vishnu350/rs-mainspring-winder/misc/staplejig.stl

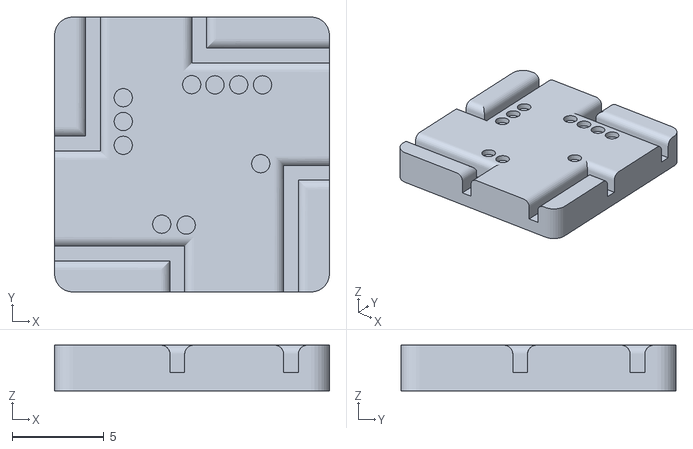
[picture p1: CAD file, 2022-07-30]
misc/staplejig.stl
15.0 x 15.0 x 2.50
