vishnu350/rs-mainspring-winder/rs-winder.FCStd

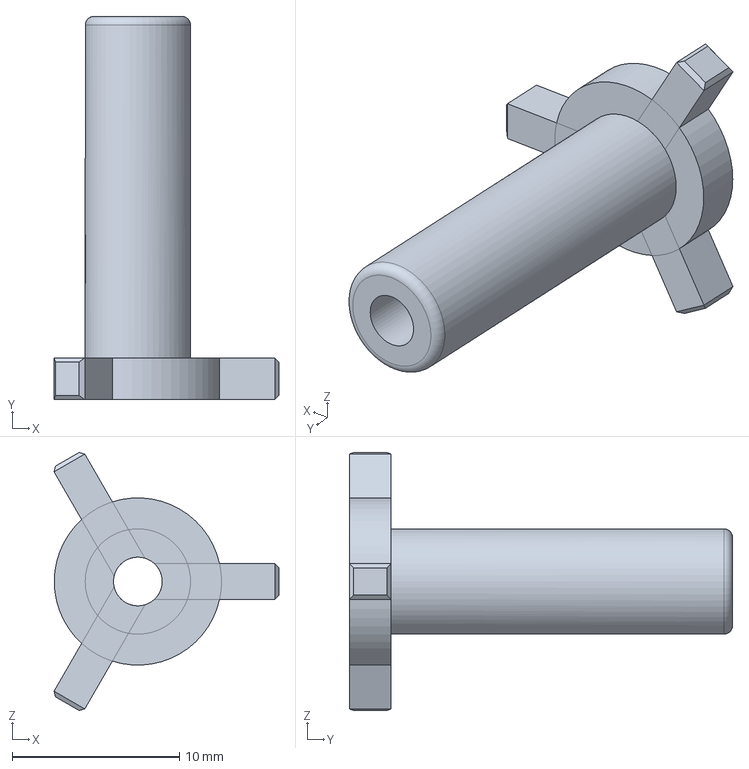
[picture p2: CAD file, 2026-08-27]
rs-winder.FCStd
13.5 x 22.9 x 15.4 mm
