vishnu350/rs-mainspring-winder/misc/sharpener_v2.FCStd

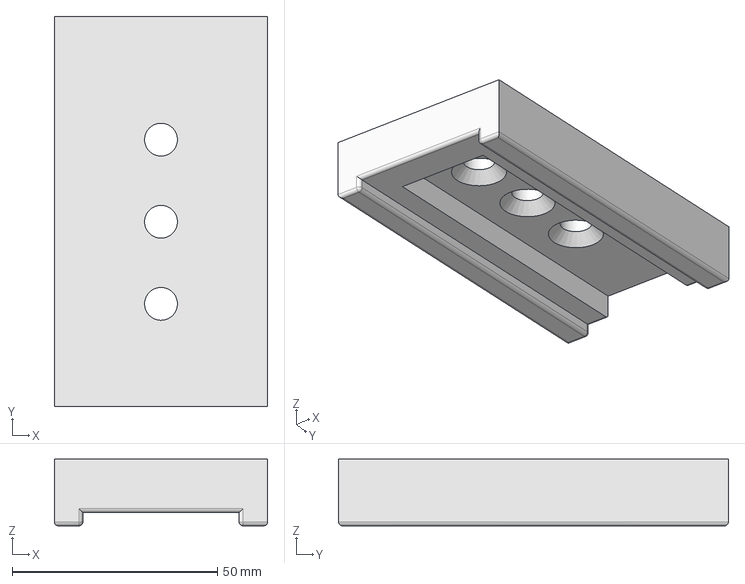
[picture p3: CAD file, 2022-07-15]
misc/sharpener_v2.FCStd
52.0 x 95.0 x 16.2 mm
