vishnu350/rs-mainspring-winder/legacy/rs-winder-v4.FCStd

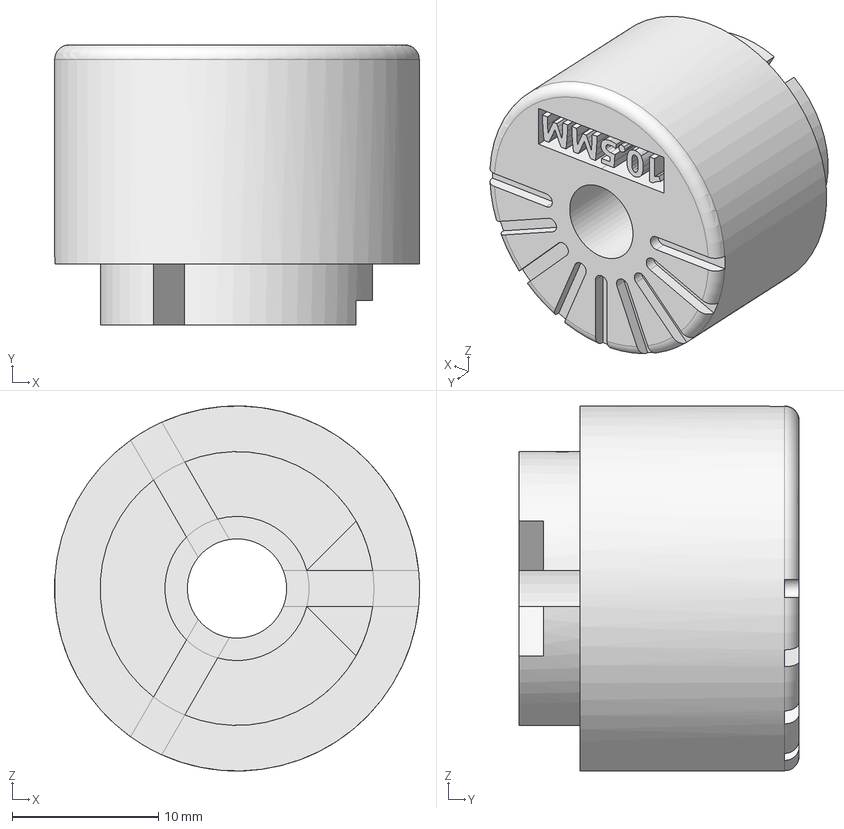
[picture p4: CAD file, 2021-05-20, an earlier design]
legacy/rs-winder-v4.FCStd
25.0 x 19.2 x 25.0 mm
