vishnu350/rs-mainspring-winder/legacy/rs-winder-v2.FCStd

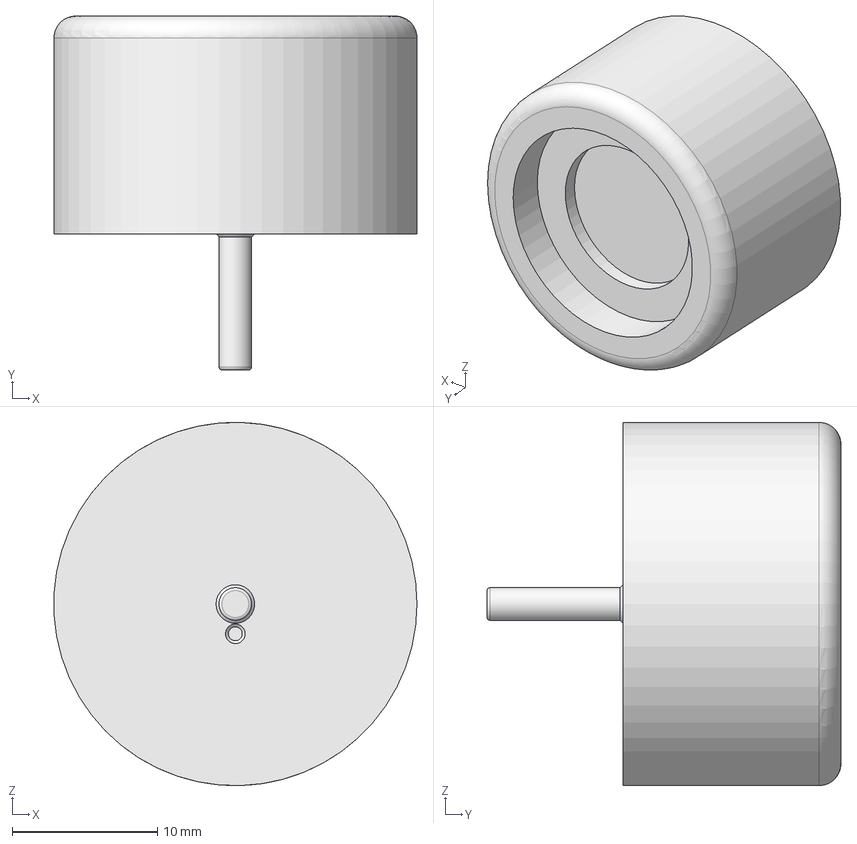
[picture p5: CAD file, 2021-05-15, an earlier design]
legacy/rs-winder-v2.FCStd
25.0 x 24.4 x 25.0 mm
