vishnu350/rs-mainspring-winder/legacy/rs-winder-v1.FCStd

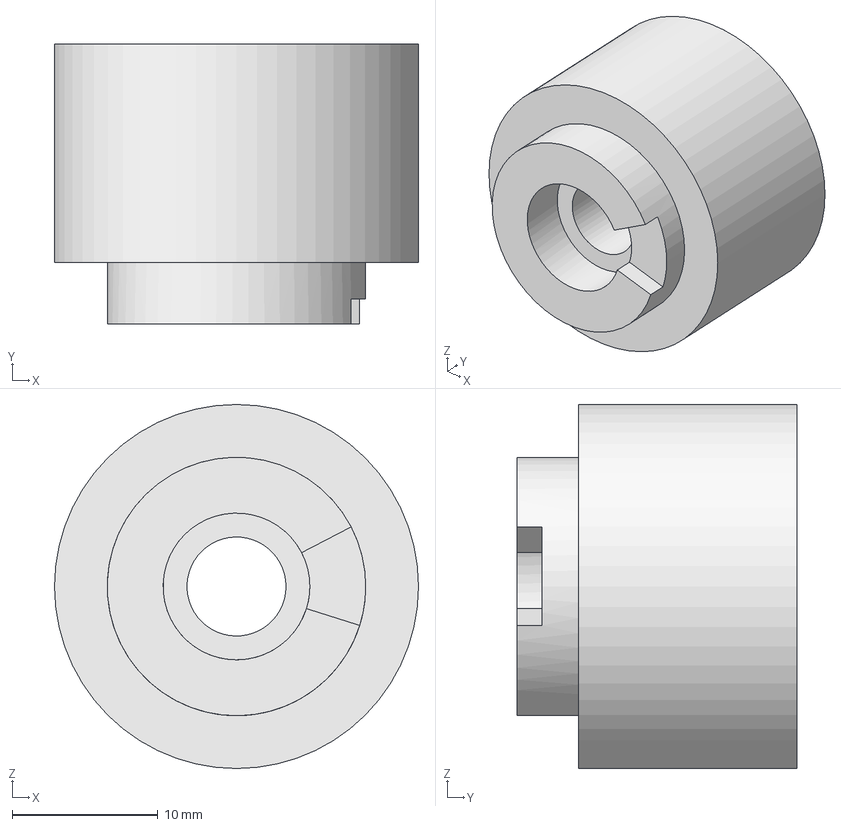
[picture p6: CAD file, 2021-05-15, an earlier design]
legacy/rs-winder-v1.FCStd
25.0 x 19.2 x 25.0 mm
