vishnu350/rs-mainspring-winder/legacy/rs-winder-v3.FCStd

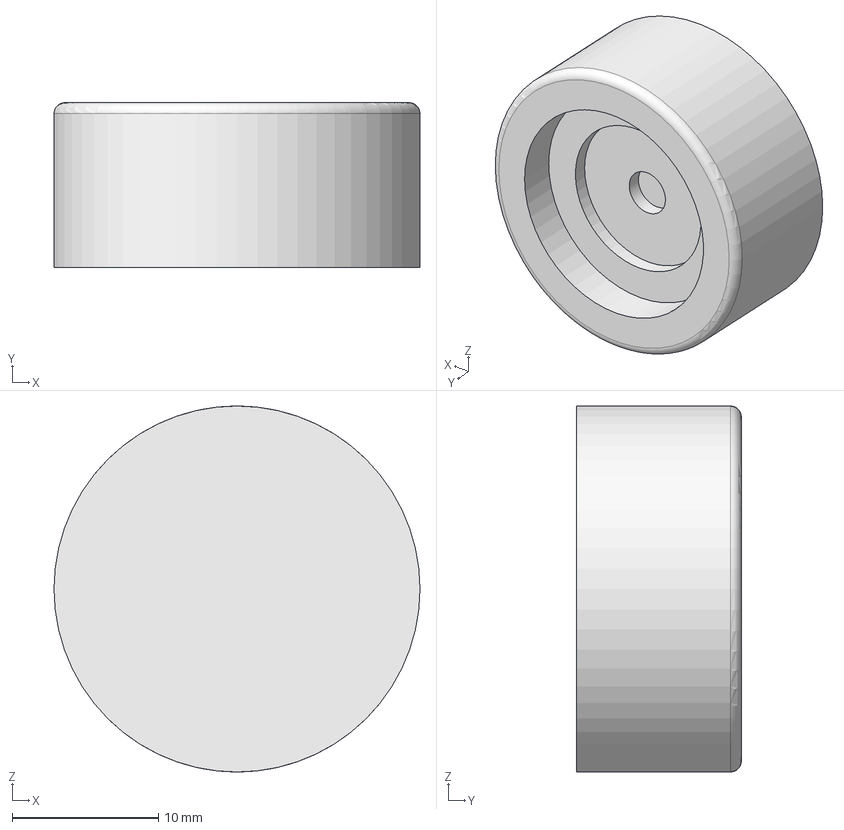
[picture p7: CAD file, 2021-05-05, an earlier design]
legacy/rs-winder-v3.FCStd
25.0 x 11.3 x 25.0 mm
