vishnu350/rs-mainspring-winder/(threads)

Thread 3 (2022-07-26):

Vintage circular coil type mainsprings will not easily fit in some smaller winders

vishnu350, 2022-07-26:
Vintage mainsprings (circular coil instead of S coil) will not easily fit in the winder due to the thick walls. See: https://www.watchrepairtalk.com/topic/19340-3d-printed-rs-mainspring-winder-project-for-hobbyists/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

vishnu350, 2022-07-27:
Experimental small winder attached.
[rs-winder-exp-small-v1.zip](https://github.com/vishnu350/rs-mainspring-winder/files/9201300/rs-winder-exp-small-v1.zip)
.

vishnu350, 2022-07-30:
User feedback is good on the new small winder version:
https://www.watchrepairtalk.com/topic/19340-3d-printed-rs-mainspring-winder-project-for-hobbyists/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

Closed 2023-01-06.

Thread 4 (2022-07-26):

Missing M3 arbour rod sizes for large winder set

vishnu350, 2022-07-26:
For the largest spectrum of winders, an M3 arbour rod size would be required.

vishnu350, 2022-08-01:
Resolved in latest version.

Closed 2022-08-01.

Thread 5 (2022-07-26):

Missing M1.5 arbour rod sizes for small winder set

vishnu350, 2022-07-26:
For the smallest spectrum of winders, an M1.5 arbour rod would be ideal.

vishnu350, 2022-08-01:
Resolved in latest release.

Closed 2022-08-01.

Thread 6 (2022-07-26):

Staple pins do not work well in the 7mm mainspring range

vishnu350, 2022-07-26:
Staple pins do not work well in the 7mm mainspring range, as they have hole sizes of 0.25mm which is too small. See: https://www.watchrepairtalk.com/topic/19340-3d-printed-rs-mainspring-winder-project-for-hobbyists/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

vishnu350, 2022-07-27:
Currently the only workaround is to file down the staple pin, or just buy a [0.2mm spring steel](https://www.aliexpress.com/item/4000995284553.html) and fashion into the arbour hook with the staplejig.

Thread 7 (2022-07-26):

Retire the winder base with 3D printed arbor rod

vishnu350, 2022-07-26:
This part needs to be retired to avoid issues with users accidentally printing this version and suffering.

vishnu350, 2022-08-05:
Latest release no longer has this part.

Closed 2022-08-05.

Thread 8 (2022-07-26):

Retire the barrel bowl and insert the arbour hole in setter bowl instead

vishnu350, 2022-07-26:
This part is no longer needed.

Only advantage of barrel bowl is the arbour hole that helps with snapping the barrel lid back on. This feature needs to be inserted into the setter bowl and then this part can be retired.

AndyShap2020, 2022-07-28:
I think I have already addressed this issue. In the "Placing Base" I have created, I designed it with a hole accommodate the arbor.

vishnu350, 2022-08-05:
Latest release no longer has this part.

Closed 2022-08-05.

Thread 10 (2022-07-30):

The winder size text never prints out cleanly

vishnu350, 2022-07-30:
This issue may be due to elephants feet issue since the text is printed on the bed.
**Solution**: Maybe switch text to embossed instead of extruded.

vishnu350, 2022-11-19:
Still doesn't print properly in v0.91 with embossed text.

vishnu350, 2022-11-20:
Fixed in v0.95

Closed 2022-11-20.

Thread 11 (2022-07-30):

Fillets too small in some parts, causing elephants foot

vishnu350, 2022-07-30:
Housing barrel and bowl fillets are too small.

vishnu350, 2022-11-18:
Fixed in v0.9.

Closed 2022-11-18.

Thread 12 (2022-07-30):

Barrel walls for 17.5mm-18.5mm too thin

vishnu350, 2022-07-30:
Barrel walls for the 17.5mm-18.5mm ranges are too thin, not sure if this is suitable for actual use especially since this is on the large spectrum.

vishnu350, 2024-04-11:
Since no one has complained about the latest version, closing this for now.

Closed 2024-04-11.

Thread 9 (2022-07-30):

Spring diameter shrink % parameter may not be needed?

vishnu350, 2022-07-30:
Currently, winders have a preset 5% reduced size to be able to properly handle matching barrel sizes. This may be confusing to some users who choose slightly smaller winders by default.
Eg. if the winder was labelled 10mm but it has a preset 5% reduced size to be able to properly handle a 10mm mainspring (thus actually making it 9.5mm or so).

vishnu350, 2022-08-27:
Experimental version with shrink param set to 0: [rs-winder-v0.87.zip](https://github.com/vishnu350/rs-mainspring-winder/files/9437245/rs-winder-v0.87.zip)

vishnu350, 2022-09-02:
Latest release resolves this issue.

Closed 2022-09-02.

Thread 13 (2022-11-07):

Housing depth too deep?

jhaals, 2022-11-07:
Hi and first of all fantastic to see an open source mainspring winder! Really love the idea!

I printed the latest 0.91 release but I'm experiencing some issues while winding the mainspring. Primarily that it tends to not align height wise if that makes sense. Basically the main spring does not lie flat and some part of the spring taking up more space vertically. Inspecting the housing of the housing it is basically twice the height of the mainspring. Are there a good reason for doing it that way or does it make sense for the housing to be slimmed down?

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

The spring takes up all spaces marked in red where 50% of the height would be enough.

Thanks again for taking on this project 👏

vishnu350, 2022-11-08:
Thanks for the support. Actually, I just press down on the plunger to bring it down flush just before I start winding. It stays that way until the end, no issues. Have you tried that?

The parameter that you are referring to is the max spring height (spr_h). You may change it and regenerate it if you wish. The large default value that we set is because there are mainsprings that can be up to 3mm in height, filtered by popularity on cousins UK. There is no standards for these things unfortunately, so we have to include support for the upper limit.

jhaals, 2022-11-08:
I do try pushing with the plunger at the beginning, it might be that the extra hight allows it to climb up if not perfectly fed in perfectly straight. I will give it a few extra tries or adjust the spring hight as you suggest, thanks for sharing the parameter as that might be a quick option to prevent the risk entirely 👍

vishnu350, 2022-11-12:
You may check Andy's video at min 0:48: [https://youtu.be/EZvd_MKBOUQ?t=48](https://youtu.be/EZvd_MKBOUQ?t=48). In the video he instructs users to apply continuous pressure to keep the spring flat, this should work in all cases as it would be impossible for it to climb up.

jhaals, 2022-11-13:
Hi!

I did try with another mainspring today but unfortunately it yielded the same result, the sprint curled up. I did apply pressure during winding but the spring curled on the side of the plunger as it’s only pushing down in the very center. Does it make sense to have an even wider punch that can apply pressure?

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

vishnu350, 2022-11-14:
It looks like the "teeth" to your plunger is missing, this part stops the mainspring from sliding in. Is this v0.91?

jhaals, 2022-11-14:
Oh lord.... I realised I used the pusher upside down! 😓 I feel so stupid. That should absolutely solve my problem, thanks a lot @vishnu350 🙇

Closed 2022-11-14.

Thread 14 (2022-11-19):

Option to generate 3mf files

vishnu350, 2022-11-19:
Next version will include 3mf files in addition to stl for reduced size and potentially better print quality.

vishnu350, 2022-11-20:
Fixed in v0.95.

Closed 2022-11-20.

Thread 15 (2022-11-19):

Bowl deepness is still an issue in v0.9

vishnu350, 2022-11-19:
Bowl relies on surface A instead of surface C, which is the closest to the mainspring and may cause issues if prints are uneven.
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

vishnu350, 2022-11-20:
Fixed in v0.95.

Closed 2022-11-20.
