vishnu350/rs-mainspring-winder/(commit log)

2021-05-04 Added RS winder FreeCAD project files.
    [rs-winder.FCStd]
2021-05-05 Added latest design file version.
    [rs-winder.FCStd]
2021-05-06 Fixed font to use FreeSansBold.
    [rs-winder.FCStd]
2021-05-06 Text fixups.
    [rs-winder.FCStd]
2021-05-07 Fixed issue with text alignment.
    [rs-winder.FCStd]
2021-05-15 Added legacy FCStd file versions for easier comparison.
    [rs-winder-v1.FCStd, rs-winder-v2.FCStd, rs-winder-v3.FCStd]
2021-05-15 Updated design to include plunger teeth pattern for better plunging action.
    [rs-winder.FCStd]
2021-05-17 Fixed bowl size mismatch with housing barrel across different mainspring sizes
    [rs-winder.FCStd]
2021-05-20 Decreased barrel shrink param.
    [rs-winder.FCStd]
2021-05-20 Swapped FreeSans to Ubuntu font for better text 3D print quality.
2021-05-20 Updated generate flow and added 11.8mm barrel bowl size.
2021-05-30 Updated design to include multiple anchor holes for compatibility.
    [rs-winder.FCStd]
2021-05-31 Updated mainspring size range.
    [rs-winder.FCStd]
2021-06-10 Added v4 winder in legacy dir.
    [rs-winder-v4.FCStd]
2021-06-10 Changed generate.stl to unix ff.
2021-06-10 Some fixes: - Updated plunger to have better clearance values for better fit. - Updated winder base to have holes closer to the arbor.
    [rs-winder.FCStd]
2021-06-10 Updated generate.stl
2021-06-12 Reduced clearance for bowl barrel slot with pi.
    [rs-winder.FCStd]
2021-06-13 First batch of changes to winder base for enabling dover pins.
    [rs-winder.FCStd]
2021-06-13 Made changes to winder base such that two versions can be generated.
    [rs-winder.FCStd]
2022-07-15 Minor updates to the base winder design: - Added setter hole at the underside of bowl - Slightly increased winder base hole size (+0.02mm)
    [rs-winder.FCStd]
2022-07-15 Added params for setting hole depth and diameter for mainspring extrusion (plunging prep).
    [rs-winder.FCStd]
2022-07-15 Generate script updates: - Added a new generated part: setter-bowl-large and setter-bowl-normal. - Some minor changes on tolerances for the mainspring and arbor hook based on user feedback. - Updated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
2022-07-15 Added misc folder with related design files.
    [StapleJig.step, sharpener_v2.FCStd]
2022-07-16 Updates to improve print quality: - Removed setter hole underneath bowl base, not needed and reduces print quality. - Added fillet for bowl base edge to reduce print error. - Slightly reduced setter 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
    [rs-winder.FCStd]
2022-07-16 Removed arbor hole for bowl-setter, added clearer comments for generate_stl.py
2022-07-24 Added AndyShap's staplejig.stl
    [StapleJig.step, staplejig.stl]
2022-07-30 Added Andy's latest 4 sided staple jig.
    [staplejig.stl]
2022-07-30 Increased fillet sizes for bowl and housing barrel to improve print quality.
    [rs-winder.FCStd]
2022-07-30 Updated version text to be embossed instead of extruded, and fixed sizings to be larger.
    [rs-winder.FCStd]
2022-07-30 Added barrel wall shave pocket, to limit the barrel wall thickness. Currently set to 3mm (bwall_t parameter).
    [rs-winder.FCStd]
2022-07-30 Completed setter bowl changes, invert it to become a placer base. The old style bowl is retired.
    [rs-winder.FCStd]
2022-07-30 Retired winder base with arbour, and added M1.5, M2.0, M2.5 and M3.0 dowel pin options.
2022-09-02 Some design updates: - Completely removed the shrink parameter so that sizes in mm will always be true. - Slightly increased the wall thickness values. - Slightly increased the extrusion depth for th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
    [rs-winder.FCStd]
2022-11-19 Fixed winder text markings.
    [rs-winder.FCStd]
2022-11-19 Removed barrel diameter parameter as it is no longer needed, and misc cleanups.
    [rs-winder.FCStd]
2022-11-19 Added view hole to bowl so that the depth can be seen.
    [rs-winder.FCStd]
2022-11-20 Fixed teeth clearance, too loose.
    [rs-winder.FCStd]
2022-11-20 Made barrel bowl a little bit tighter to fit to reduce play.
    [rs-winder.FCStd]
2022-11-20 Changed font to better type for printing, adjust size.
    [rs-winder.FCStd]
2022-11-20 Increased spring extrude depth.
2022-11-20 Updates: - Fixed text positioning and depth, prints correctly now (finally). - Fixed bowl fillet options for best functionality. - Fixed bowl depth for ideal spring extrusion.
    [rs-winder.FCStd]
2022-11-21 Updated README, added into zip file generation flow with versioning.
2023-07-09 Updated fonts to be larger.
    [rs-winder.FCStd]
2024-04-10 Updated model to include parameterized fillet at barrel wall edge for better print quality.
    [rs-winder.FCStd]
2025-03-29 Added experimental "small" winders.
    [rs-winder.FCStd]
